sudo-junkie/IoT_AgriFarm/README.md

# IoT_AgriFarm

KiCad 7 design files (schematic, PCB, BOM, gerbers) for a solar powered smart farm controller based on RP2040

-	USB-C - firmware upload & debugging
-	24V 2A Boost converter - to power water pump
-	RS-485 transciever - for NPK sensor
-	Soil moisture, soil temperature, soil PH relative humidity and ambient temperature sensors

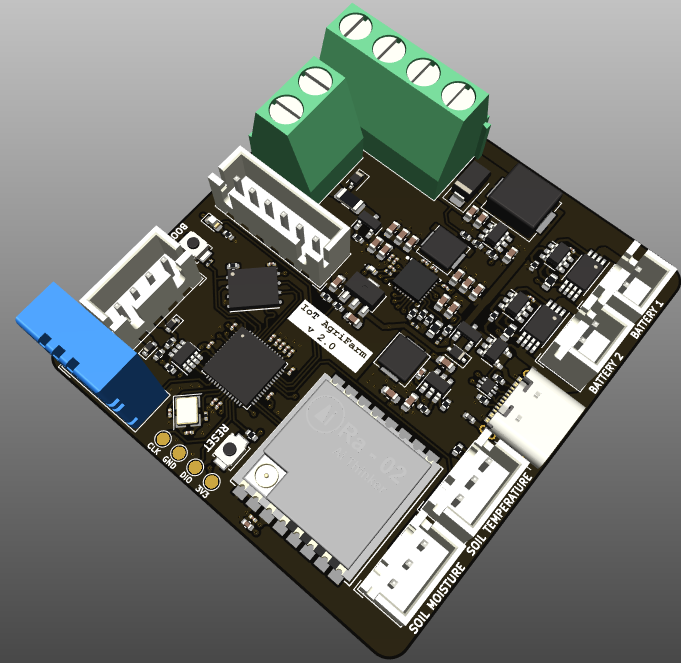
[picture p1: IMAGES/IoT_Agrifarm11.png]


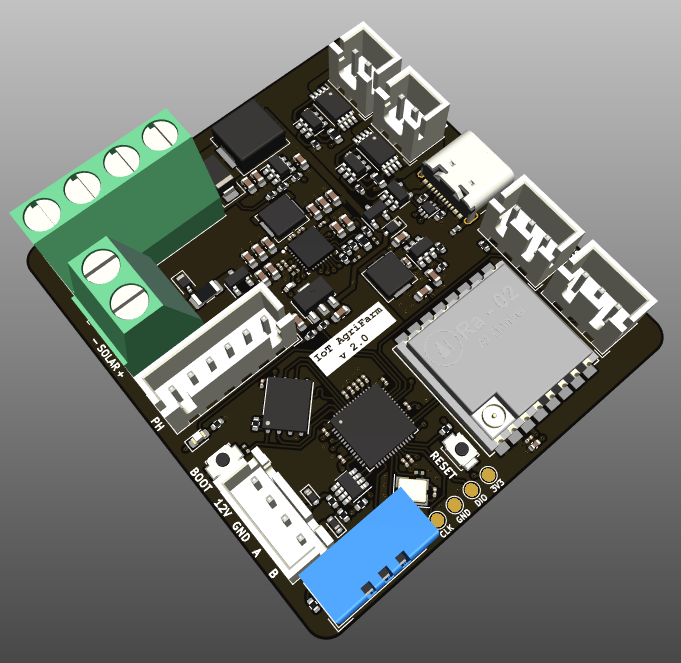
[picture p2: IMAGES/IoT_Agrifarm13.png]


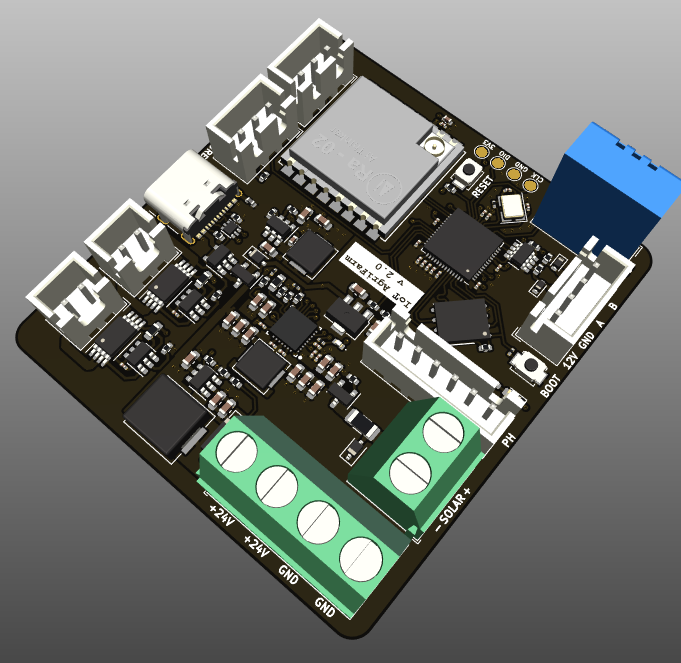
[picture p3: IMAGES/IoT_Agrifarm15.png]


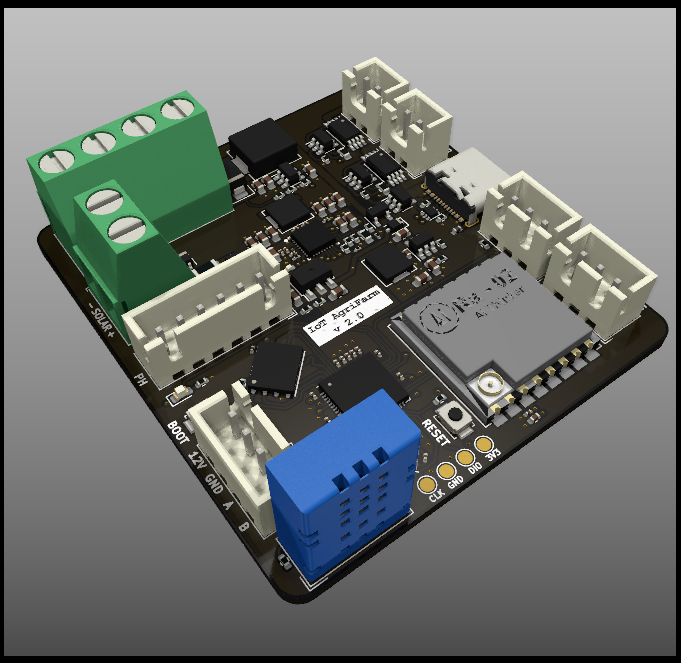
[picture p4: IMAGES/IoT_Agrifarm16.png]
