sudo-junkie/IoT_AgriFarm/IMAGES/IoT_Agrifarm1.png

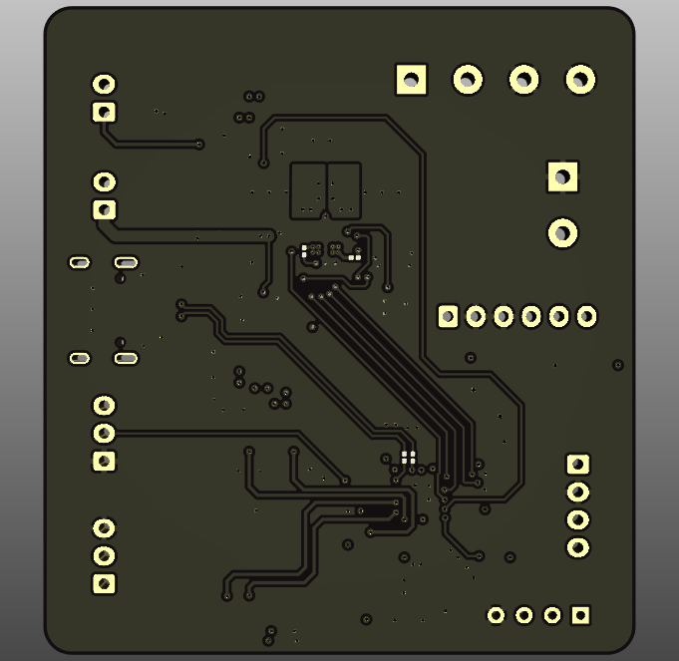
IMAGES/IoT_Agrifarm1.png
