sudo-junkie/IoT_AgriFarm/IMAGES/IoT_Agrifarm2.png

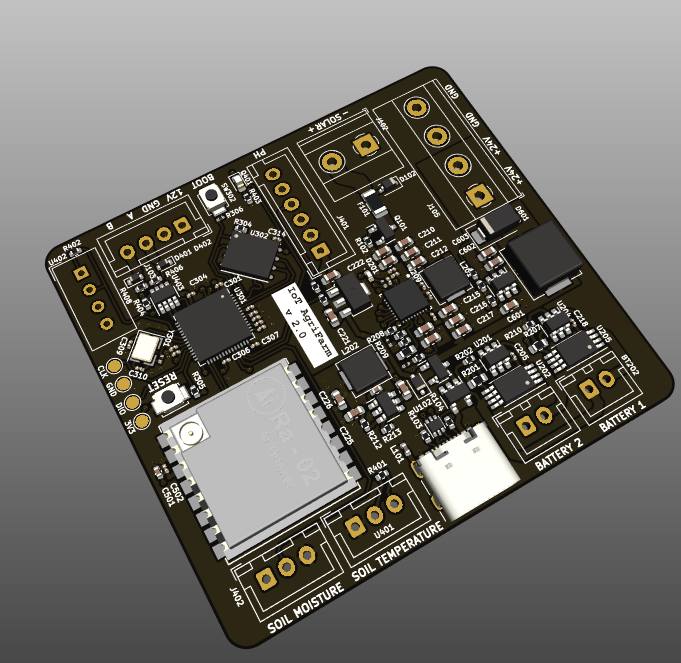
IMAGES/IoT_Agrifarm2.png
