sudo-junkie/IoT_AgriFarm/IMAGES/IoT_Agrifarm3.png

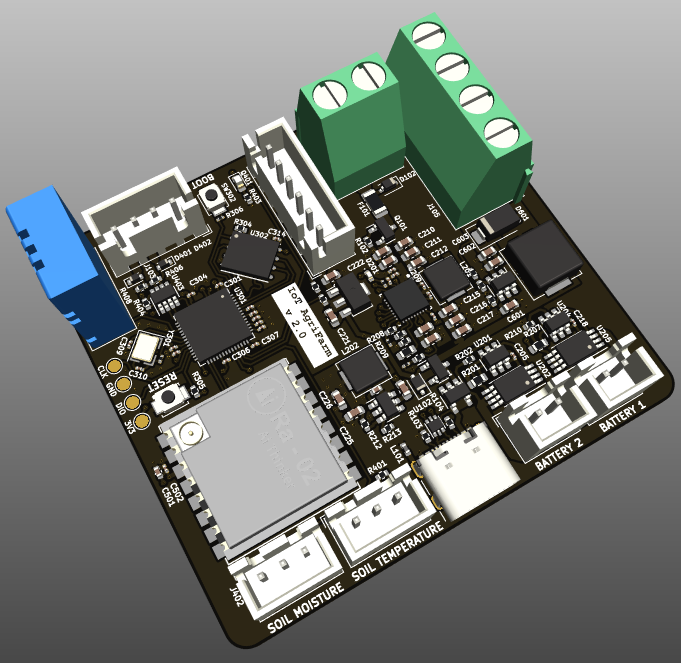
IMAGES/IoT_Agrifarm3.png
