sudo-junkie/IoT_AgriFarm/IMAGES/IoT_Agrifarm4.png

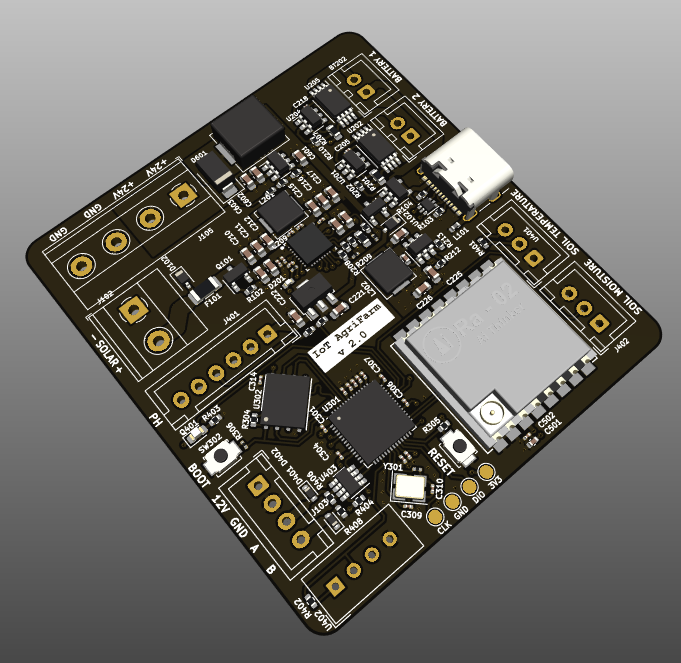
IMAGES/IoT_Agrifarm4.png
