sudo-junkie/IoT_AgriFarm/IMAGES/IoT_Agrifarm6.png

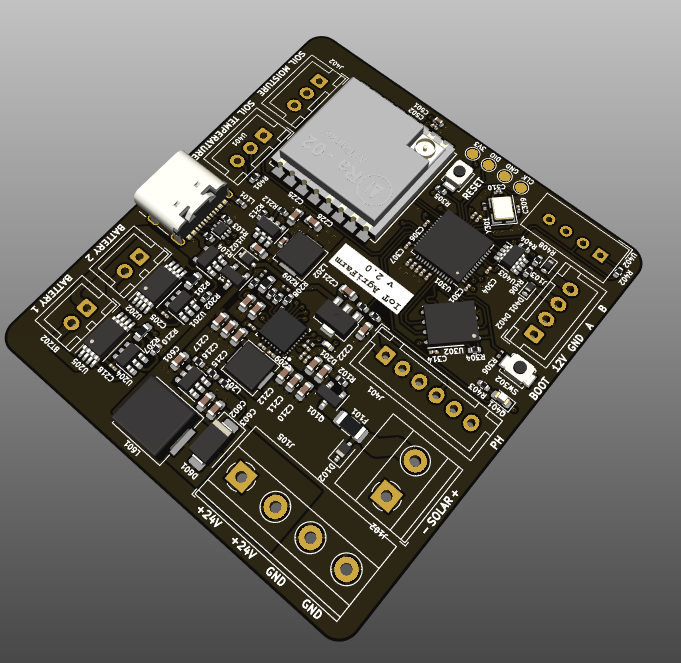
IMAGES/IoT_Agrifarm6.png
