sudo-junkie/IoT_AgriFarm/IMAGES/IoT_Agrifarm7.png

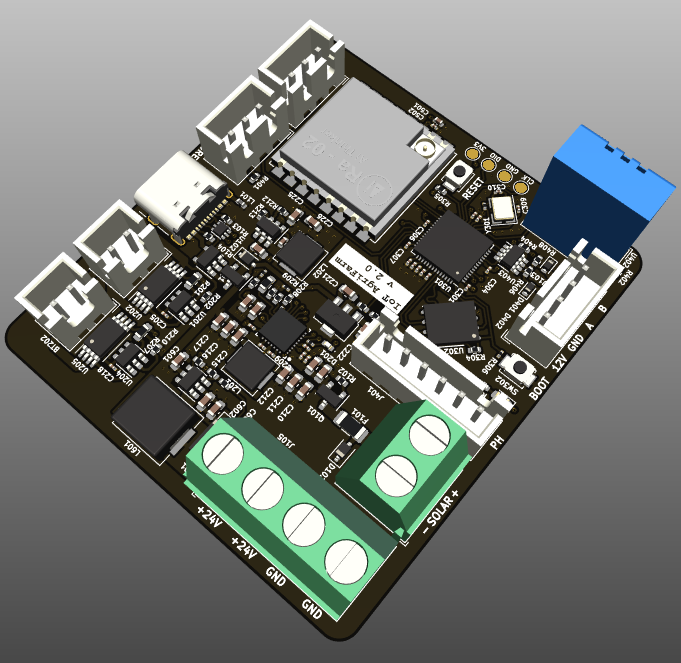
IMAGES/IoT_Agrifarm7.png
