sudo-junkie/IoT_AgriFarm/IMAGES/IoT_Agrifarm8.png

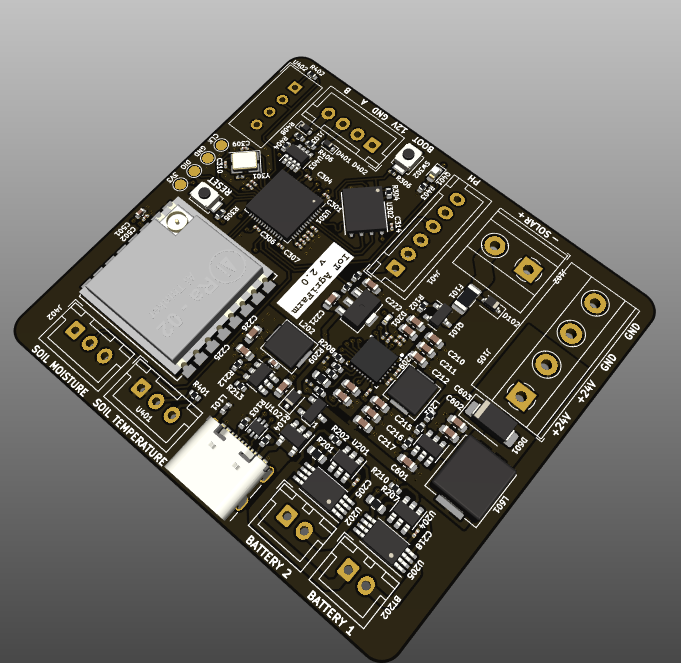
IMAGES/IoT_Agrifarm8.png
