sudo-junkie/IoT_AgriFarm/IMAGES/IoT_Agrifarm9.png

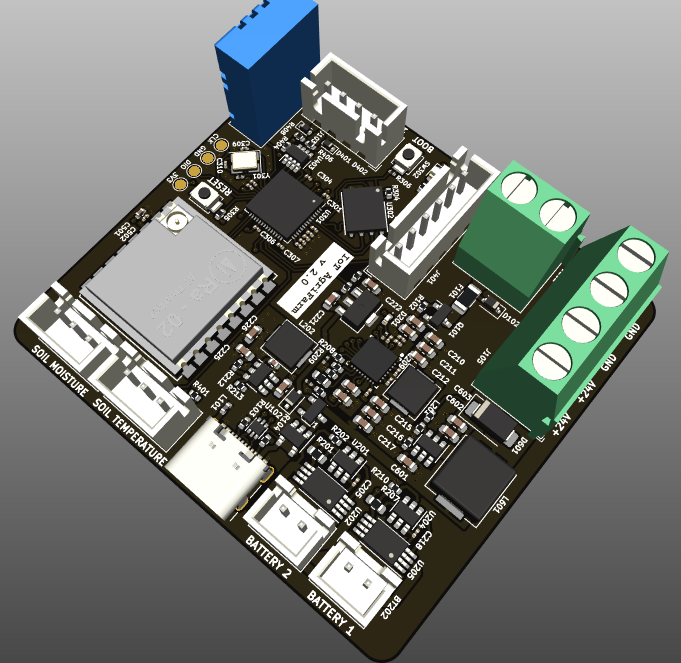
IMAGES/IoT_Agrifarm9.png
