sudo-junkie/IoT_AgriFarm/IMAGES/IoT_Agrifarm10.png

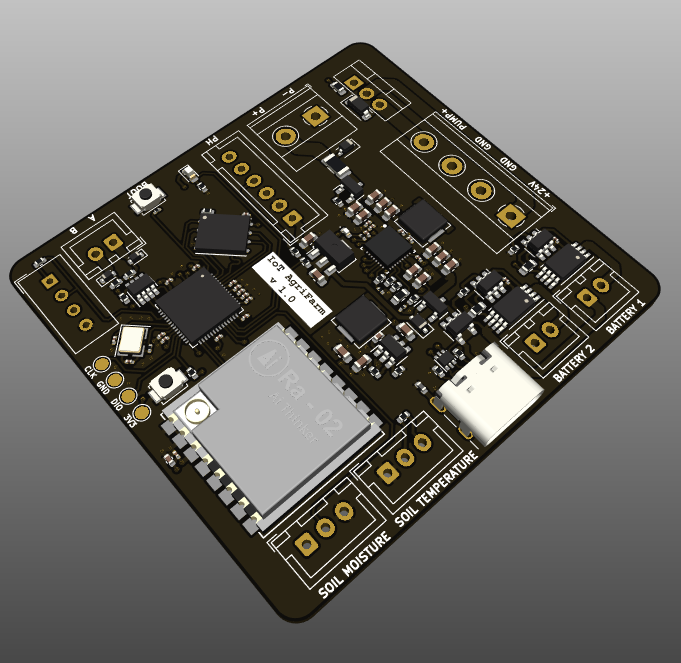
IMAGES/IoT_Agrifarm10.png
