sudo-junkie/IoT_AgriFarm/IMAGES/IoT_Agrifarm14.png

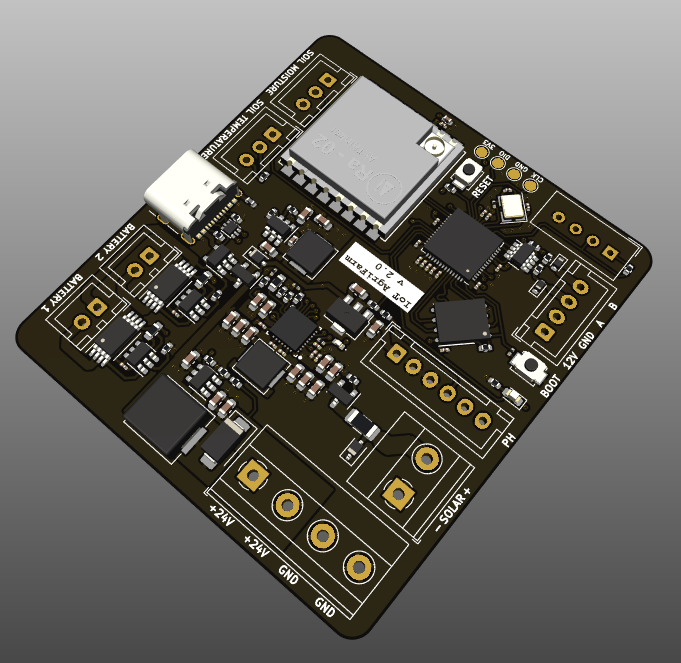
IMAGES/IoT_Agrifarm14.png
