sudo-junkie/IoT_AgriFarm/IMAGES/IoT_Agrifarm.png

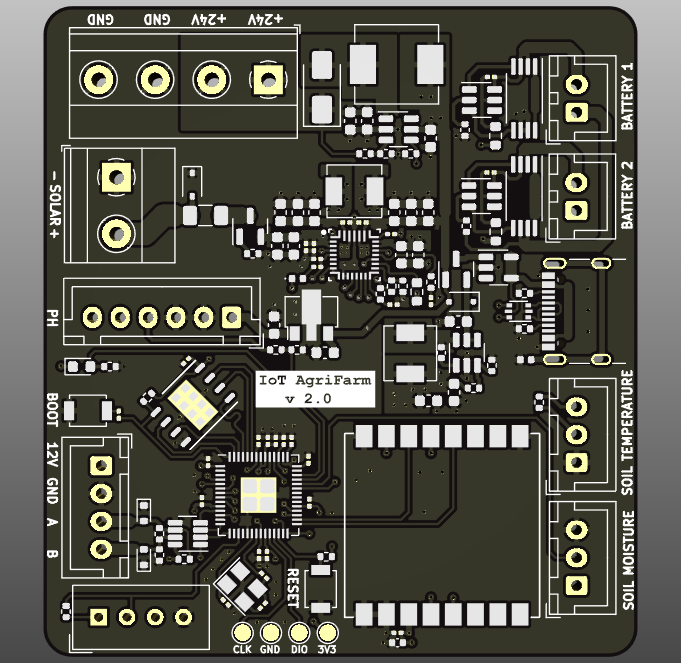
IMAGES/IoT_Agrifarm.png
