sudo-junkie/IoT_AgriFarm/SRC/IoT_Agrifarm.kicad_pcb

## KiCad design SRC/IoT_Agrifarm.kicad_pcb (2023-07-06)

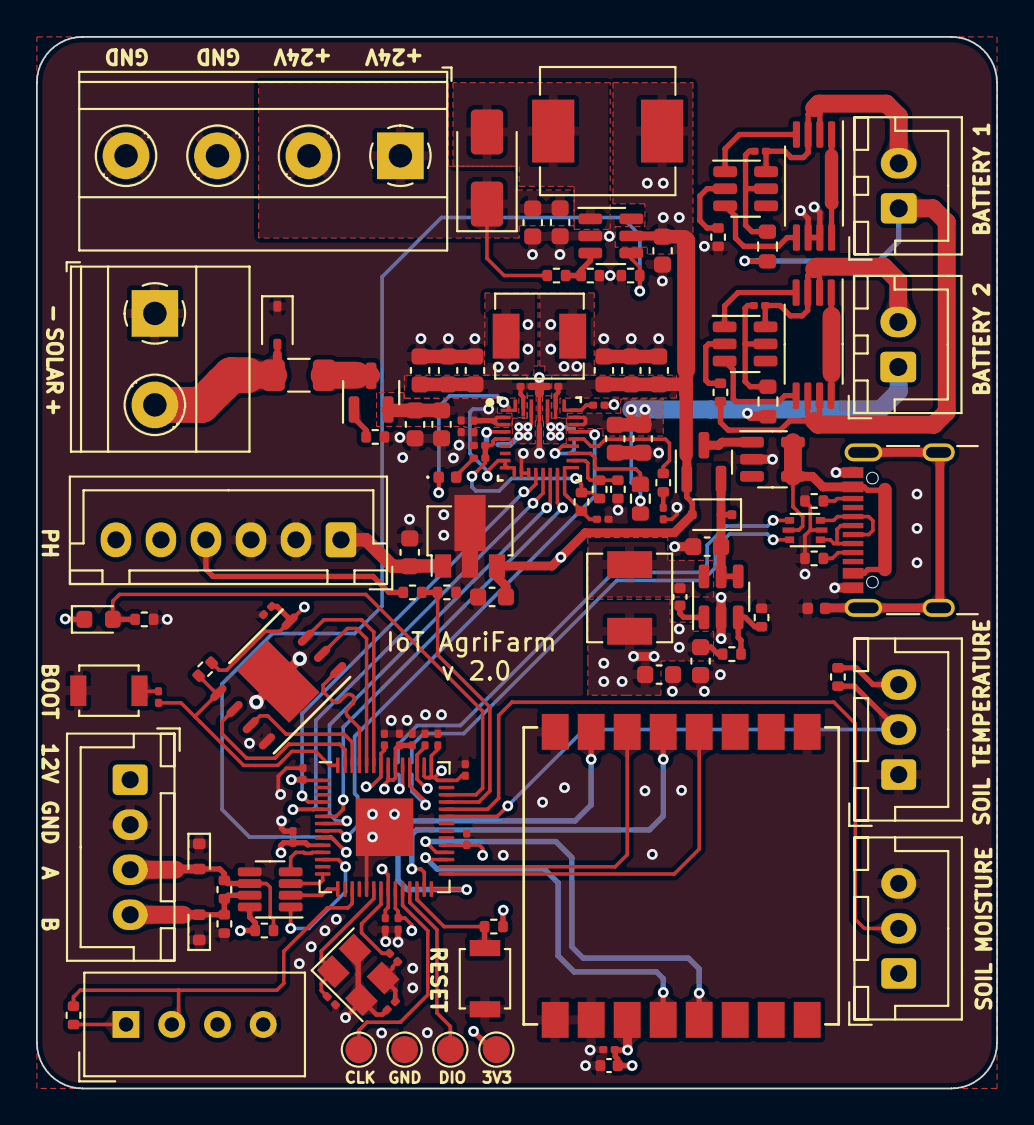
[picture p22: board IoT_Agrifarm.kicad_pcb from above]

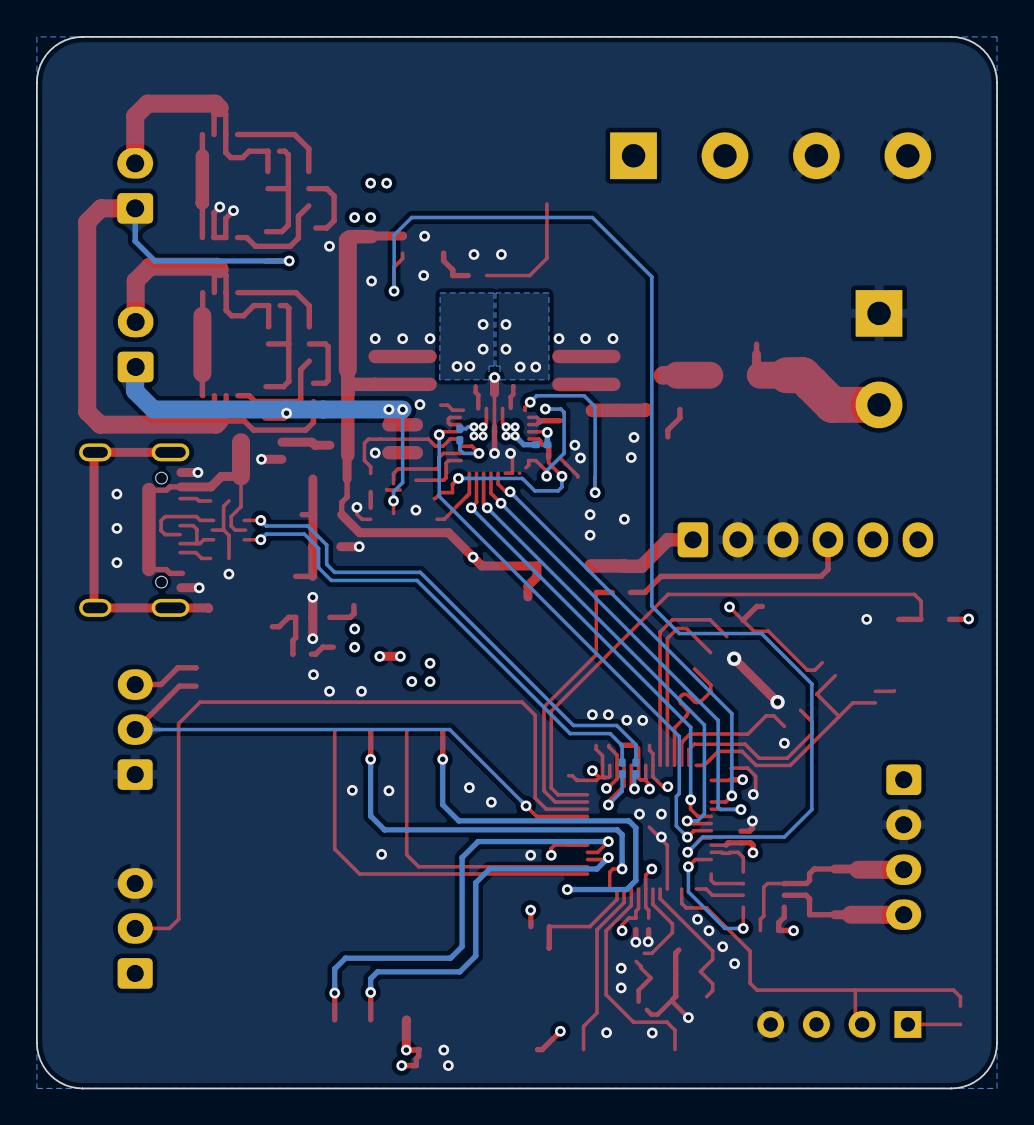
[picture p23: board IoT_Agrifarm.kicad_pcb from below]

Board: 4 copper layers, 53.3 x 58.4 mm, 124 parts (4 on the bottom side), 92 nets.

Parts:
BT201: BATT2; JST_XH_B2B-XH-A_1x02_P2.50mm_Vertical
BT202: BATT1; JST_XH_B2B-XH-A_1x02_P2.50mm_Vertical
C201, C202, C205, C207, C209, C214, C218, C301, C302, C303, C304, C305, C306, C307, C311, C312, C314, C502: 100n; C_0201_0603Metric
C203, C204, C210, C211, C212, C215, C216, C217, C219, C220, C221, C222, C224, C225, C226, C601, C602, C603: 10u; C_0603_1608Metric
C206: 1n; C_0201_0603Metric
C208, C213: 47n; C_0201_0603Metric
C223: 22n; C_0402_1005Metric
C308, C313: 1u; C_0201_0603Metric
C309, C310: 22p; C_0201_0603Metric
C501: 2u2; C_0402_1005Metric
D101: D_TVS; D_SOD-323
D201: LED_STAT; LED_0402_1005Metric
D202: 2.5A; D_SOD-323F
D401, D402: ESD131; D_SOD-523
D601: SS34; D_SMA
F101: Fuse; Fuse_1206_3216Metric
J101: J_PUMP; TerminalBlock_Phoenix_MKDS-1,5-4-5.08_1x04_P5.08mm_Horizont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
J102: J_PANEL; TerminalBlock_Phoenix_MKDS-1,5-2-5.08_1x02_P5.08mm_Horizont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
J103: Conn_NPK; JST_XH_B4B-XH-A_1x04_P2.50mm_Vertical
J104: USB_C_Receptacle_USB2.0; USB_C_Receptacle_GCT_USB4105-xx-A_16P_TopMnt_Horizontal
J401: Conn_PH; JST_XH_B6B-XH-A_1x06_P2.50mm_Vertical
J402: Conn_MOISTURE; JST_XH_B3B-XH-A_1x03_P2.50mm_Vertical
L101: 1u 10% 15mA; L_0402_1005Metric
L201, L202: 1u 20% 4.5A; L_Sunlord_MWSA0412S
L601: 10u; L_Sunlord_MWSA0603S
Q101, Q201: AO3401A; SOT-23
Q401: Q_Photo_NPN; LED_0603_1608Metric
R101, R305, R404, R405, R406, R407, R408: 10K; R_0402_1005Metric
R102, R103, R208, R211, R603: 5K1; R_0402_1005Metric
R201, R205, R207: 100R; R_0603_1608Metric
R202, R210, R304, R401, R402, R403: 1K; R_0402_1005Metric
R203: 127K; R_0402_1005Metric
R204, R213: 100K; R_0402_1005Metric
R206: 2K2; R_0201_0603Metric
R209: 33K; R_0201_0603Metric
R212, R301, R306: 1.05K; R_0201_0603Metric
R214: 25K5; R_0402_1005Metric
R302, R303: 27R; R_0201_0603Metric
R601: 200K; R_0402_1005Metric
R602: 1M; R_0402_1005Metric
SW301: SW_Push; SW_SPST_B3U-1000P
SW302: SW_BOOT; SW_SPST_B3U-1000P
TP301: TP_3V3; TestPoint_Pad_D1.5mm
TP302: TP_SWDCLK; TestPoint_Pad_D1.5mm
TP303: TP_GND; TestPoint_Pad_D1.5mm
TP304: TP_SWDIO; TestPoint_Pad_D1.5mm
U101: AP2171W; SOT-23-5
U102: USBLC6-2P6; SOT-666
U201, U204: DW01A; SOT-23-6
U202, U205: 8205A; TSSOP-8_4.4x3mm_P0.65mm
U203: BQ25672RQMR; RQM0029A-MFG
U206: L78L05; SOT-89-3
U207: SD8942; SOT-23-6
U301: RP2040; QFN-56-1EP_7x7mm_P0.4mm_EP3.2x3.2mm
U302: 25Q128; DFN-S-8-1EP_6x5mm_P1.27mm
U401: DS18B20; JST_XH_B3B-XH-A_1x03_P2.50mm_Vertical
U402: DHT11; Aosong_DHT11_5.5x12.0_P2.54mm
U403: MAX3362; SOT-23-8
U501: Ai-Thinker-Ra-02; Ai-Thinker-Ra-01-LoRa
U601: SY7208; SOT-23-6
Y301: 12MHz; Crystal_SMD_3225-4Pin_3.2x2.5mm

Connections:
+1V1: C311.1, C312.1, C313.1, U301.23 (DVDD), U301.45 (VREG_VOUT), U301.50 (DVDD)
+3V3: C225.1, C226.1, C301.1, C302.1, C303.1, C304.1, C305.1, C306.1, C307.1, C308.1, C314.1, C501.1, C502.1, J402.1, L202.1, Q401.1 (C), R213.2, R304.2, R305.2, R401.1, R402.1, R404.1, TP301.1, U301.1 (IOVDD), U301.10 (IOVDD), U301.22 (IOVDD), U301.33 (IOVDD), U301.42 (IOVDD), U301.43 (ADC_AVDD), U301.44 (VREG_IN), U301.48 (USB_VDD), U301.49 (IOVDD), U302.8 (VCC), U401.3 (V_{DD}), U402.1 (VCC), U403.8 (VCC), U501.3 (VDD)
+5V: C222.1, J401.1, U206.1 (OUT)
+12V: C214.1, C215.1, C216.1, C217.1, C221.1, C601.1, D202.2 (A), J103.1, L601.1, Q201.1 (G), U203.25 (SYS), U206.3 (IN), U601.5 (VIN)
/IOT_AGRIFARM_POWER/BATT1+: BT202.1 (+), R202.2, R207.1, U202.6 (S2), U202.7 (S2)
/IOT_AGRIFARM_POWER/BATT1-: BT202.2 (-), C218.2, U204.6 (GND), U205.2 (S1), U205.3 (S1)
/IOT_AGRIFARM_POWER/BATT2+: BT201.1 (+), C219.1, C220.1, R201.1, R205.2, U203.22 (BAT), U203.23 (BAT)
/IOT_AGRIFARM_POWER/BATT2-: BT201.2 (-), C205.2, U201.6 (GND), U202.2 (S1), U202.3 (S1)
/IOT_AGRIFARM_POWER/BQ_SCL: U203.14 (SCL), U301.7 (GPIO5)
/IOT_AGRIFARM_POWER/BQ_SDA: U203.15 (SDA), U301.6 (GPIO4)
/IOT_AGRIFARM_POWER/BQ_~CE: U203.13 (~CE), U301.5 (GPIO3)
/IOT_AGRIFARM_POWER/BQ_~INT: U203.21 (~INT), U301.8 (GPIO6)
/IOT_AGRIFARM_POWER/BQ_~QON: U203.12 (~QON), U301.4 (GPIO2)
/IOT_AGRIFARM_POWER/BUCK_IN: C224.1, D202.1 (K), Q201.2 (S), U207.4 (EN), U207.5 (VIN)
/IOT_AGRIFARM_POWER/BUCK_SW: C223.2, L202.2, U207.6 (SW)
/IOT_AGRIFARM_POWER/PMID: C209.1, C210.1, C211.1, C212.1, U203.29 (PMID)
/IOT_AGRIFARM_POWER/REGN: C207.1, R203.1, R206.1, R208.1, U203.5 (REGN)
/IOT_AGRIFARM_POWER/SW1: C208.1, L201.1, U203.28 (SW1)
/IOT_AGRIFARM_POWER/SW2: C213.1, L201.2, U203.26 (SW2)
/IOT_AGRIFARM_POWER/V_PANEL: C201.1, C202.1, C203.1, C204.1, Q101.2 (S), U203.2 (VBUS), U203.3 (VBUS), U203.8 (VAC2), U203.9 (VAC1)
/IOT_AGRIFARM_SENSORS/485_RX: U301.12 (GPIO9), U403.1 (RO)
/IOT_AGRIFARM_SENSORS/485_TX: U301.11 (GPIO8), U403.4 (DI)
/IOT_AGRIFARM_SENSORS/485_TX_EN: U301.14 (GPIO11), U403.3 (DE)
/IOT_AGRIFARM_SENSORS/DHT_SENSOR: R402.2, U301.17 (GPIO14), U402.2 (IO)
/IOT_AGRIFARM_SENSORS/LIGHT_SENSOR: Q401.2 (E), R403.1, U301.40 (GPIO28_ADC2)
/IOT_AGRIFARM_SENSORS/NPK_A: D402.2 (A2), J103.3, R404.2, R406.1, U403.6 (A)
/IOT_AGRIFARM_SENSORS/NPK_B: D401.2 (A2), J103.4, R406.2, R408.1, U403.7 (B)
/IOT_AGRIFARM_SENSORS/SOIL_MOISTURE: J402.2, U301.38 (GPIO26_ADC0)
/IOT_AGRIFARM_SENSORS/SOIL_PH: R405.2, R407.1, U301.39 (GPIO27_ADC1)
/IOT_AGRIFARM_SENSORS/SOIL_TEMP: R401.2, U301.37 (GPIO25), U401.2 (DQ)
/IOT_AGRIFARM_SENSORS/~485_RX_EN: U301.15 (GPIO12), U403.2 (~RE)
/MCU_RP2040/GPIO7: R602.2, U301.9 (GPIO7), U601.4 (EN)
/MCU_RP2040/GPIO16: U301.27 (GPIO16), U501.13 (MISO)
/MCU_RP2040/GPIO17: U301.28 (GPIO17), U501.15 (~NSS)
/MCU_RP2040/GPIO18: U301.29 (GPIO18), U501.12 (SCK)
/MCU_RP2040/GPIO19: U301.30 (GPIO19), U501.14 (MOSI)
/MCU_RP2040/GPIO20: U301.31 (GPIO20), U501.4 (~RESET)
/MCU_RP2040/GPIO21: U301.32 (GPIO21), U501.5 (DIO0)
/MCU_RP2040/QSPI_CLK: U301.52 (QSPI_SCLK), U302.6 (CLK)
/MCU_RP2040/QSPI_SD0: U301.53 (QSPI_SD0), U302.5 (DI(IO0))
/MCU_RP2040/QSPI_SD1: U301.55 (QSPI_SD1), U302.2 (DO(IO1))
/MCU_RP2040/QSPI_SD2: U301.54 (QSPI_SD2), U302.3 (IO2)
/MCU_RP2040/QSPI_SD3: U301.51 (QSPI_SD3), U302.7 (IO3)
/MCU_RP2040/QSPI_SS: R304.1, R306.1, U301.56 (QSPI_SS), U302.1 (~CS)
/MCU_RP2040/RESET: R305.1, SW301.2, U301.26 (RUN)
/MCU_RP2040/SWCLK: TP302.1, U301.24 (SWCLK)
/MCU_RP2040/SWDIO: TP304.1, U301.25 (SWD)
/MCU_RP2040/USB_DN: R303.1, U102.6 (I/O1)
/MCU_RP2040/USB_DP: R302.1, U102.4 (I/O2)
/MCU_RP2040/XIN: C309.1, U301.20 (XIN), Y301.1
/MCU_RP2040/XOUT: R301.2, U301.21 (XOUT)
/REGULATOR_SWITCHING_SY7208/SW_24V: D601.2 (A), L601.2, U601.1 (LX)
/REGULATOR_SWITCHING_SY7208/VOUT_24V: C602.1, C603.1, D601.1 (K), J101.1, J101.2, R601.2
/USB_DN: J104.A7 (D-), J104.B7 (D-), U102.1 (I/O1)
/USB_DP: J104.A6 (D+), J104.B6 (D+), U102.3 (I/O2)
/VBUS_IN: J104.A4 (VBUS), J104.A9 (VBUS), J104.B4 (VBUS), J104.B9 (VBUS), U101.4 (EN), U101.5 (IN), U102.5 (VBUS)
Earth: J104.S1 (SHIELD), L101.1
GND: C201.2, C202.2, C203.2, C204.2, C206.1, C207.2, C209.2, C210.2, C211.2, C212.2, C214.2, C215.2, C216.2, C217.2, C219.2, C220.2, C221.2, C222.2, C224.2, C225.2, C226.2, C301.2, C302.2, C303.2, C304.2, C305.2, C306.2, C307.2, C308.2, C309.2, C310.2, C311.2, C312.2, C313.2, C314.2, C501.2, C502.2, C601.2, C602.2, C603.2, D101.1 (A1), D401.1 (A1), D402.1 (A1), J101.3, J101.4, J102.1, J103.2, J104.A1 (GND), J104.A12 (GND), J104.B1 (GND), J104.B12 (GND), J401.2, J401.3, J402.3, L101.2, R101.1, R102.2, R103.2, R204.2, R209.2, R210.2, R212.2, R214.1, R403.2, R407.2, R408.2, R602.1, R603.1, SW301.1, SW302.1, TP303.1, U101.2 (GND), U102.2 (GND), U203.10 (ACDRV2), U203.11 (ACDRV1), U203.27 (GND), U205.6 (S2), U205.7 (S2), U206.2 (GND), U207.2 (GND), U301.19 (TESTEN), U301.57 (GND), U302.4 (GND), U302.9 (EP), U401.1 (GND), U402.4 (GND), U403.5 (GND), U501.1 (GND), U501.2 (GND), U501.9 (GND), U501.16 (GND), U601.2 (GND), Y301.2, Y301.4
unnamed: C310.1, R301.1, Y301.3
unnamed: D101.2 (A2), F101.1, J102.2
unnamed: D201.2 (A), R206.2
unnamed: D201.1 (K), U203.1 (STAT)
unnamed: J104.A5 (CC1), R102.1
unnamed: J104.B5 (CC2), R103.1
unnamed: J401.4, R405.1
unnamed: F101.2, Q101.3 (D)
unnamed: Q101.1 (G), R101.2
unnamed: R211.1, R212.1
unnamed: R306.2, SW302.2
unnamed: R202.1, U201.2 (CS)
unnamed: U201.3 (OC), U202.5 (G2)
unnamed: U201.1 (OD), U202.4 (G1)
unnamed: C205.1, R201.2, U201.5 (VCC)
unnamed: U202.1 (D1), U202.8 (D2)
unnamed: R205.1, U203.18 (BATP)
unnamed: C208.2, U203.4 (BTST1)
unnamed: C213.2, U203.19 (BTST2)
unnamed: R203.2, R204.1, U203.17 (ILIM_HIZ)
unnamed: R211.2, U203.20 (PROG)
unnamed: C206.2, U203.24 (SDRV)
unnamed: R208.2, R209.1, U203.16 (TS)
unnamed: R210.1, U204.2 (CS)
unnamed: U204.3 (OC), U205.5 (G2)
unnamed: U204.1 (OD), U205.4 (G1)
unnamed: C218.1, R207.2, U204.5 (VCC)
unnamed: U205.1 (D1), U205.8 (D2)
unnamed: C223.1, U207.1 (BS)
unnamed: R213.1, R214.2, U207.3 (FB)
unnamed: R303.2, U301.46 (USB_DM)
unnamed: R302.2, U301.47 (USB_DP)
unnamed: R601.1, R603.2, U601.3 (FB)
VBUS: Q201.3 (D), U101.1 (OUT)
